Tsamsiy/USBC-to-Serial/USBCToSerial/Hardware/1.0.1_schematics.pdf

1 | RX | DTR | TX

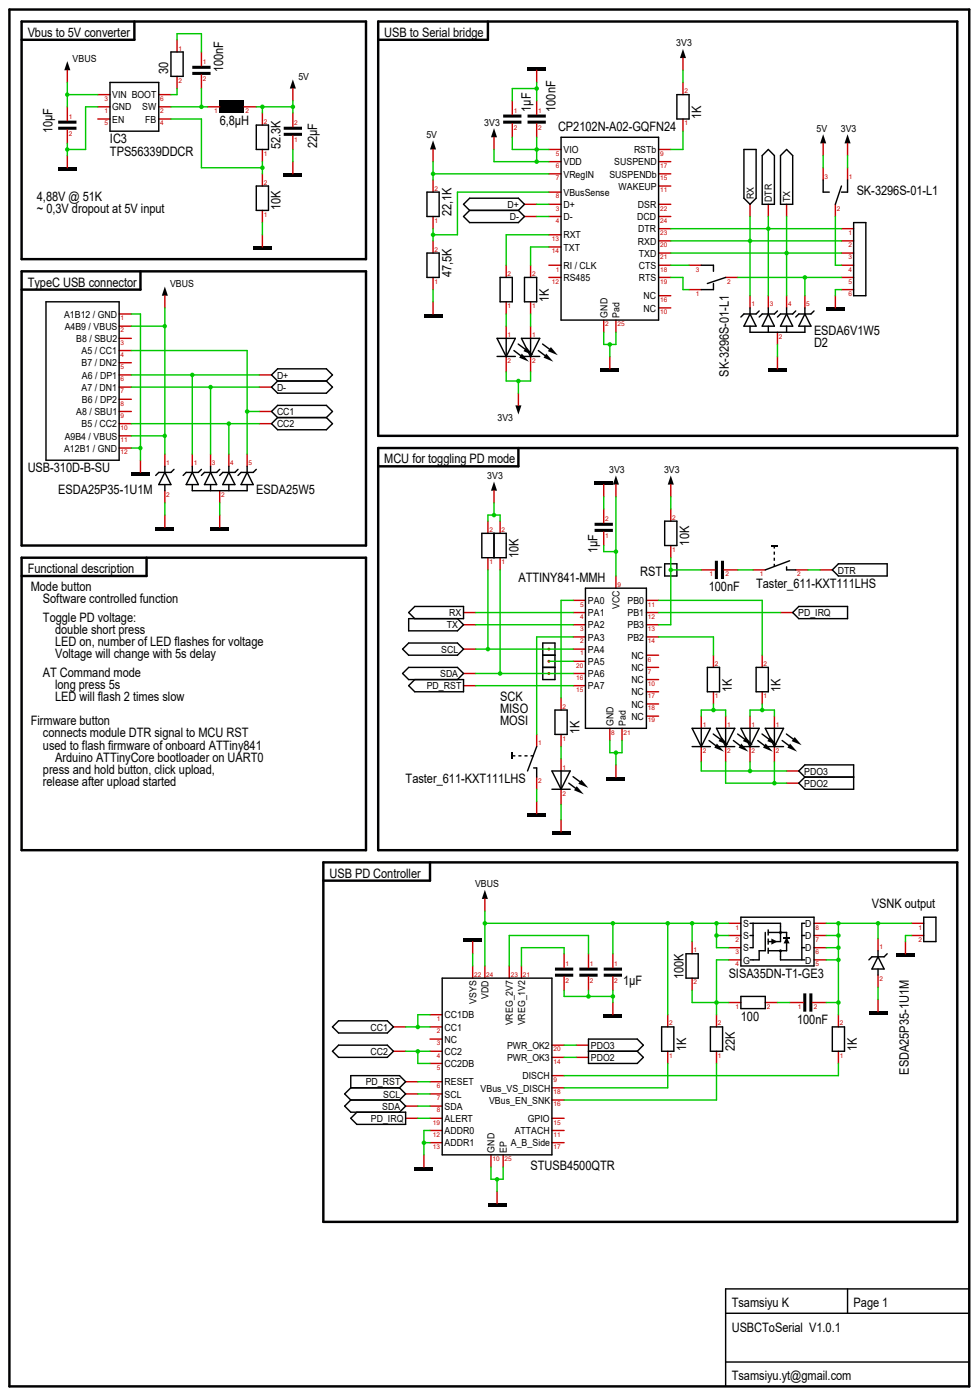
[picture p1: page 1]
VSNK output; Vbus to 5V converter; USB to Serial bridge; MOSI; MISO; SCK; RST; 1 ESDA²⁵P³⁵⁻¹U¹M; 1 ESDA25P35-1U1M; USBCToSerial V1.0.1; Tsamsiyu K; Page 1; 1 ¹⁰K; 1 30VBUS; BOOT; 3 VIN; GND SW; IC3 TPS56339DDCR; SK⁻³²⁹⁶S⁻⁰¹⁻L1 25Pad; DCD; 24 DTR; 23 DSR; 22 TXD; 21 RXD; 20 RTS; 19 CTS; 18 SUSPEND 17 NC; 16 SUSPENDb 15; 14 TXT; 13 RXT; WAKEUP; 10 RSTb; 8 VBusSense; 7 VRegIN; 6 VDD; 5 VIO; 2GND; 1 RI / CLK CP2102N-A02-GQFN24; 1 ²²K; 1 Taster_611-KXT111LHS; 1 2 Taster_611-KXT111LHS DTR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

~ 0,3V dropout at 5V input 4,88V @ 51K

TypeC USB connector

MCU for toggling PD mode

Functional description
Mode button
Software controlled function
Toggle PD voltage:
double short press
LED on, number of LED flashes for voltage
Voltage will change with 5s delay
AT Command mode
long press 5s
LED will flash 2 times slow
Firmware button
connects module DTR signal to MCU RST
used to flash firmware of onboard ATTiny841
Arduino ATTinyCore bootloader on UART0
press and hold button, click upload,
release after upload started

USB PD Controller

Tsamsiyu.yt@gmail.com
