Tsamsiy/USBC-to-Serial/USBCToSerial/Hardware/1.0.1_bottomCopper.pdf

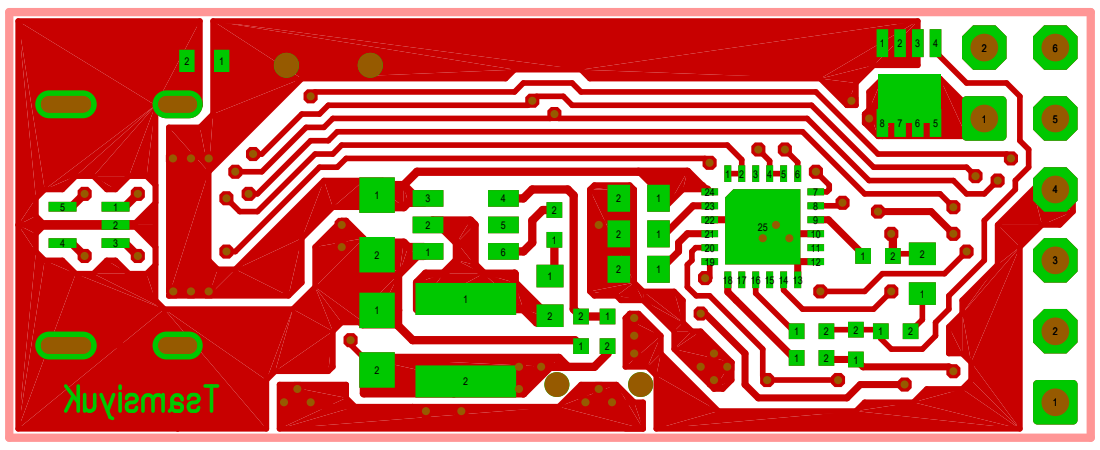
[picture p2: page 1]
