Tsamsiy/USBC-to-Serial/USBCToSerial/Hardware/1.0.1_bottomSilkScreen.pdf

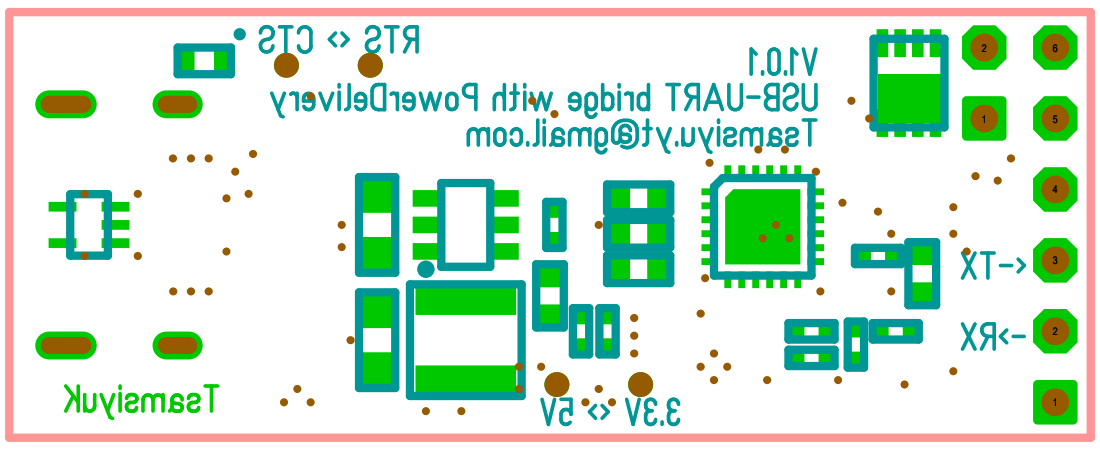
[picture p3: page 1]
