Tsamsiy/USBC-to-Serial/USBCToSerial/Hardware/1.0.1_topCopper.pdf

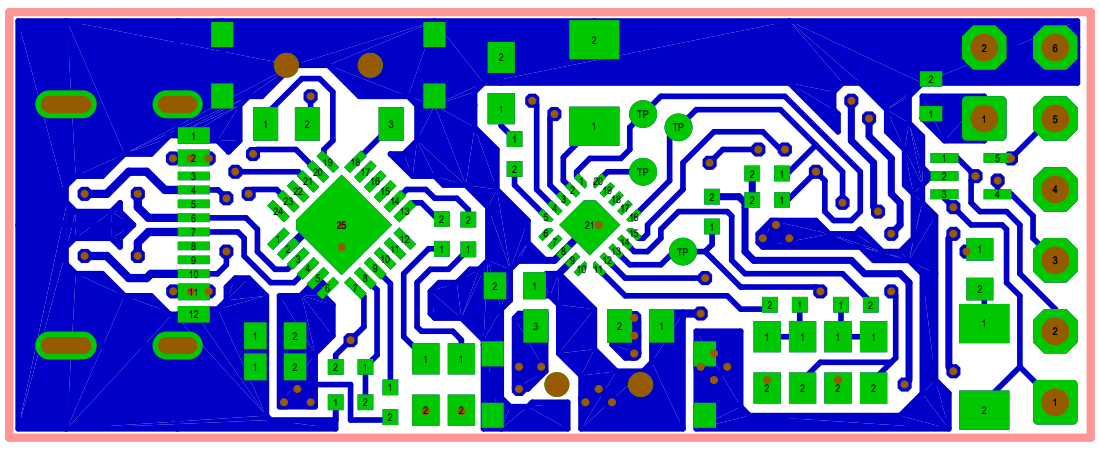
[picture p4: page 1]
