Tsamsiy/USBC-to-Serial/USBCToSerial/Hardware/1.0.1_topSilkScreen.pdf

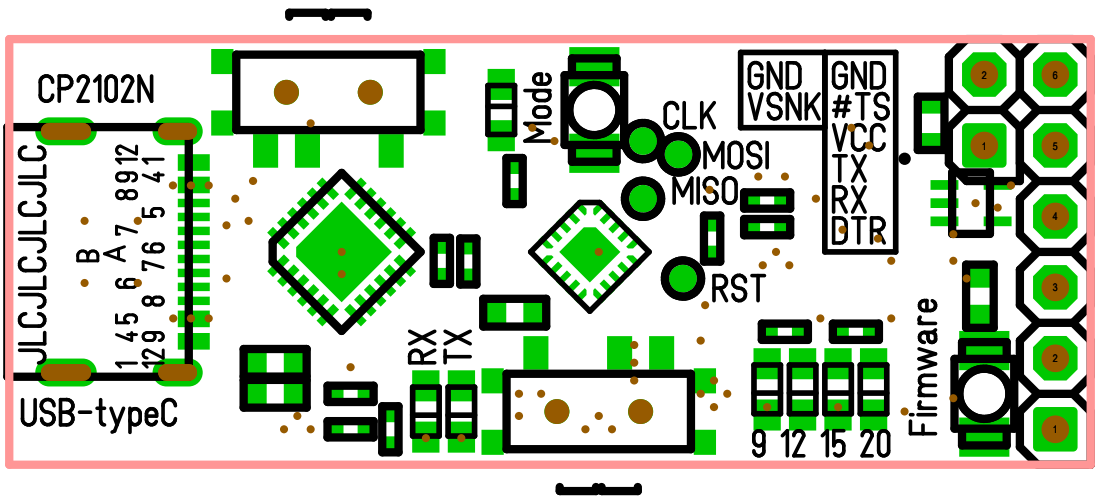
[picture p5: page 1]
